amitaibenshalom/Laser-Drawing/regular_version/python/assets/homming_notification.jpg

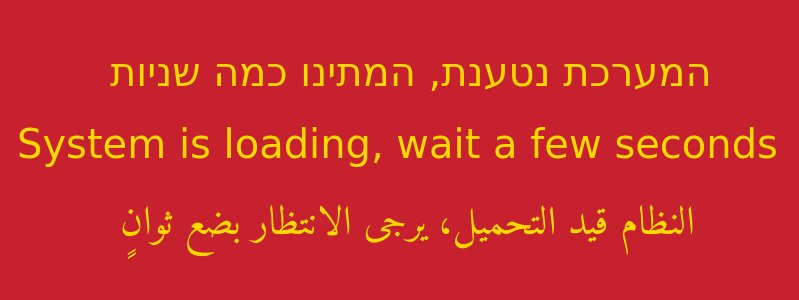
regular_version/python/assets/homming_notification.jpg
