amitaibenshalom/Laser-Drawing/שרטוטים/shield_laser.JPG

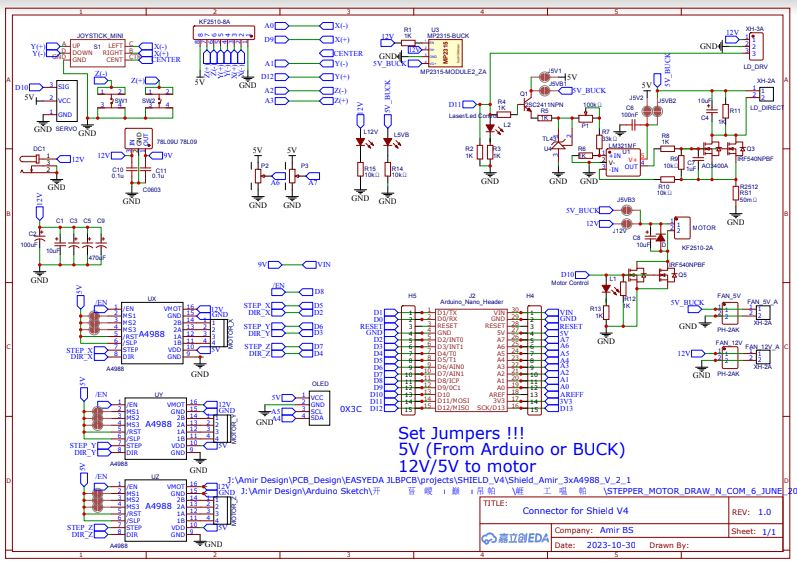
שרטוטים/shield_laser.JPG
