amitaibenshalom/Laser-Drawing/regular_version/python/assets/check.png

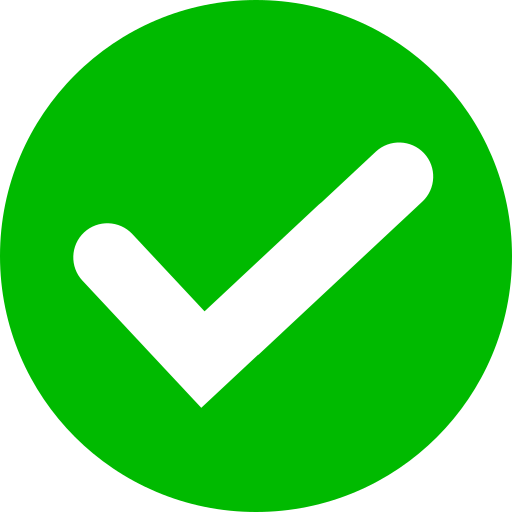
regular_version/python/assets/check.png
