amitaibenshalom/Laser-Drawing/regular_version/python/assets/circle.jpg

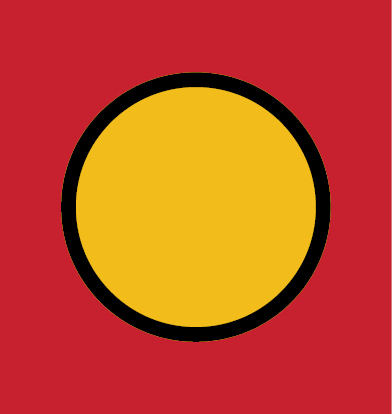
regular_version/python/assets/circle.jpg
