amitaibenshalom/Laser-Drawing/regular_version/python/assets/circlePressed.jpg

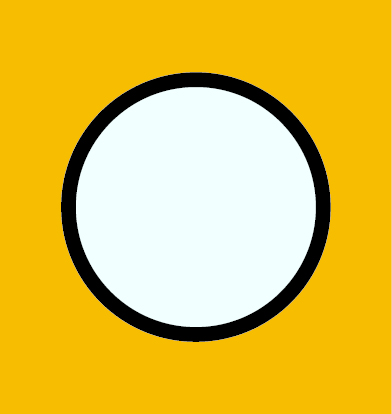
regular_version/python/assets/circlePressed.jpg
