amitaibenshalom/Laser-Drawing/regular_version/python/assets/drop.jpg

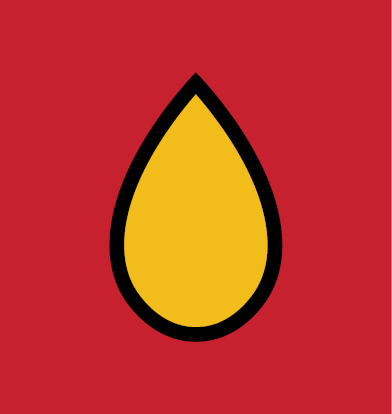
regular_version/python/assets/drop.jpg
