amitaibenshalom/Laser-Drawing/regular_version/python/assets/empty_drawing.jpg

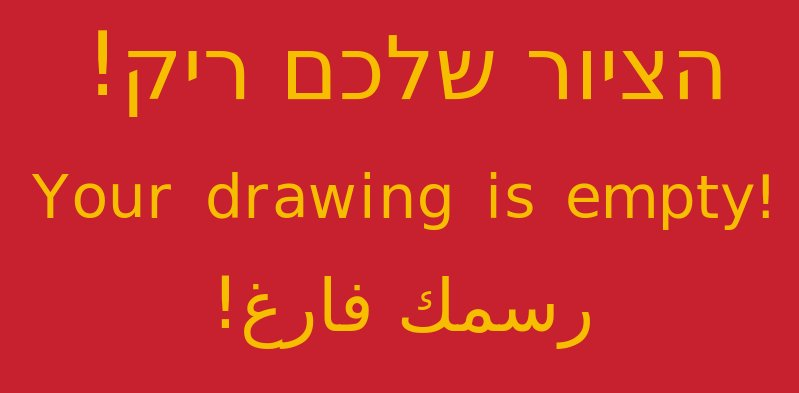
regular_version/python/assets/empty_drawing.jpg
