amitaibenshalom/Laser-Drawing/regular_version/python/assets/eraser.png

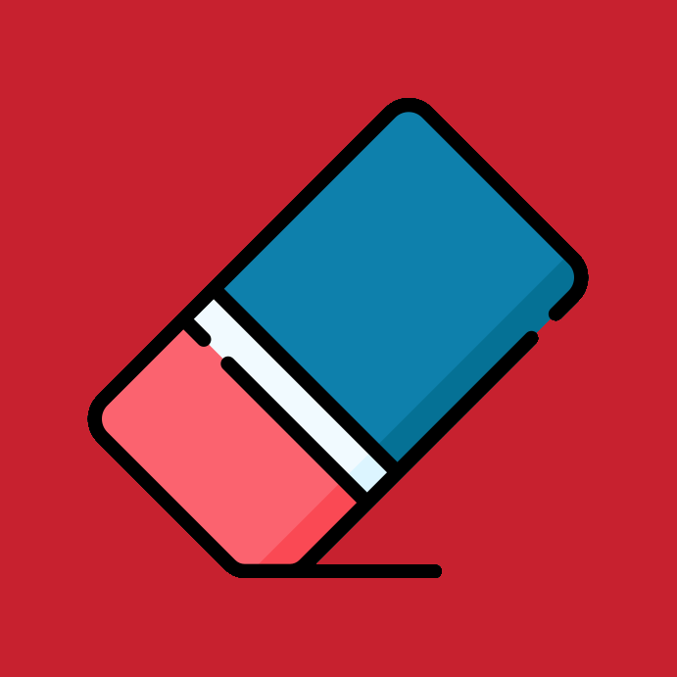
regular_version/python/assets/eraser.png
