amitaibenshalom/Laser-Drawing/regular_version/python/assets/eraserPressed.png

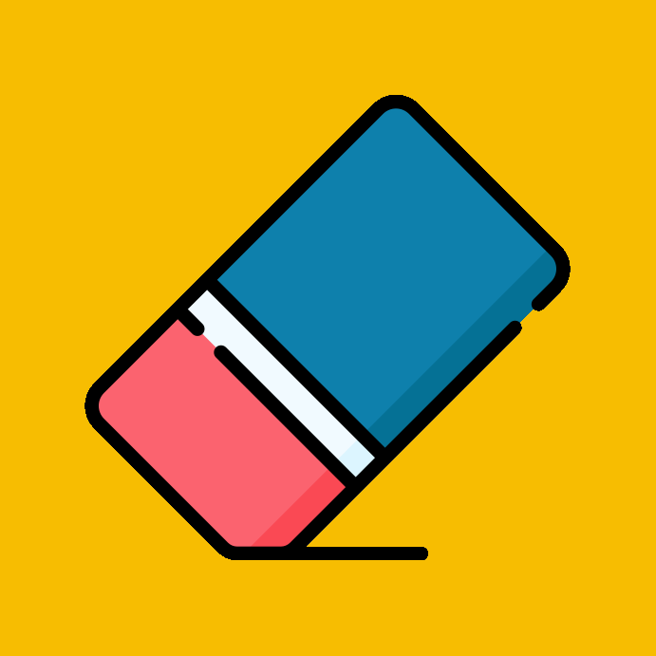
regular_version/python/assets/eraserPressed.png
