amitaibenshalom/Laser-Drawing/regular_version/python/assets/extimated_time_text.jpg

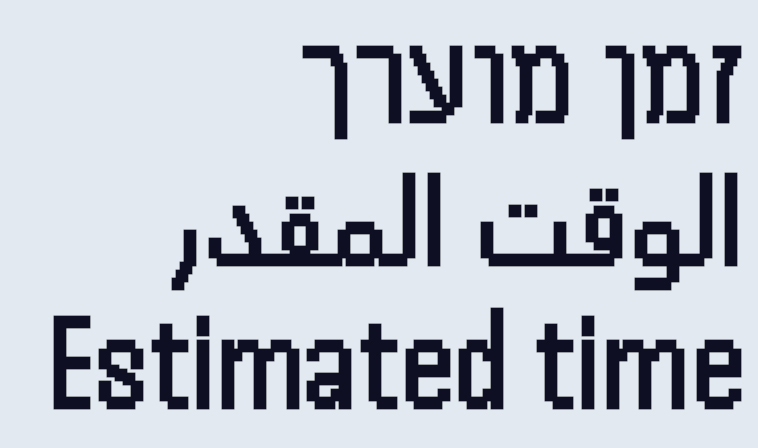
regular_version/python/assets/extimated_time_text.jpg
