amitaibenshalom/Laser-Drawing/regular_version/python/assets/frame.jpg

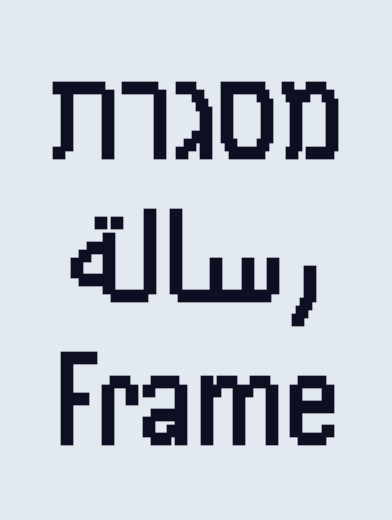
regular_version/python/assets/frame.jpg
