amitaibenshalom/Laser-Drawing/regular_version/python/assets/garbage.png

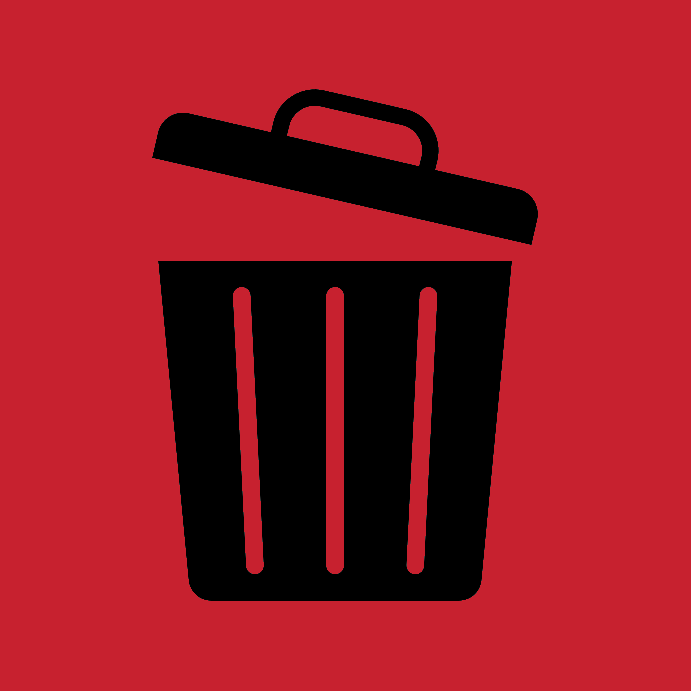
regular_version/python/assets/garbage.png
