amitaibenshalom/Laser-Drawing/regular_version/python/assets/garbagePressed.png

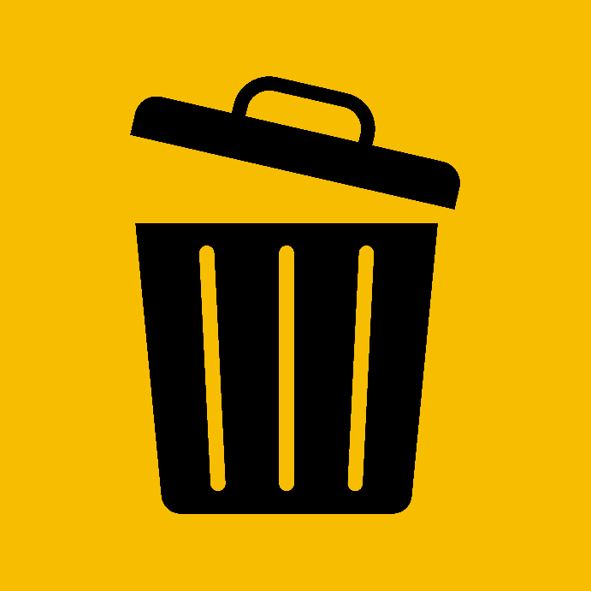
regular_version/python/assets/garbagePressed.png
