amitaibenshalom/Laser-Drawing/regular_version/python/assets/heart.jpg

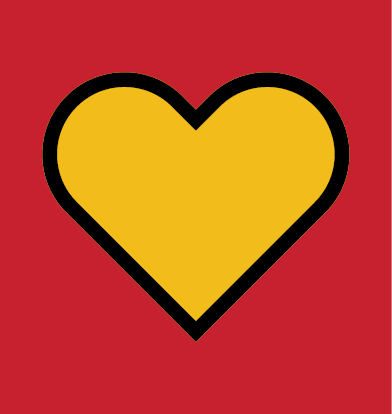
regular_version/python/assets/heart.jpg
