amitaibenshalom/Laser-Drawing/regular_version/python/assets/heartPressed.jpg

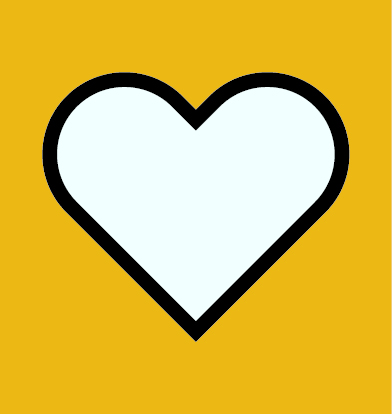
regular_version/python/assets/heartPressed.jpg
