amitaibenshalom/Laser-Drawing/regular_version/python/assets/laser_drawing_example.png

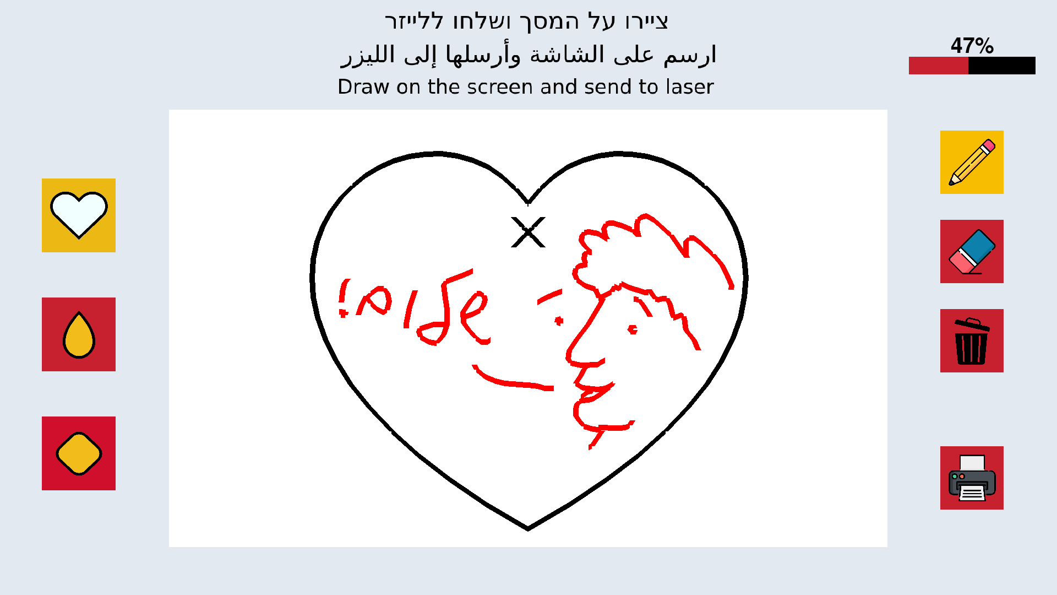
regular_version/python/assets/laser_drawing_example.png
