amitaibenshalom/Laser-Drawing/regular_version/python/assets/no.png

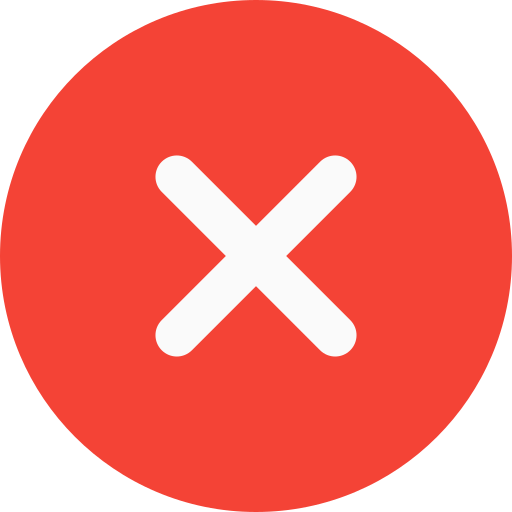
regular_version/python/assets/no.png
