amitaibenshalom/Laser-Drawing/regular_version/python/assets/pencil.png

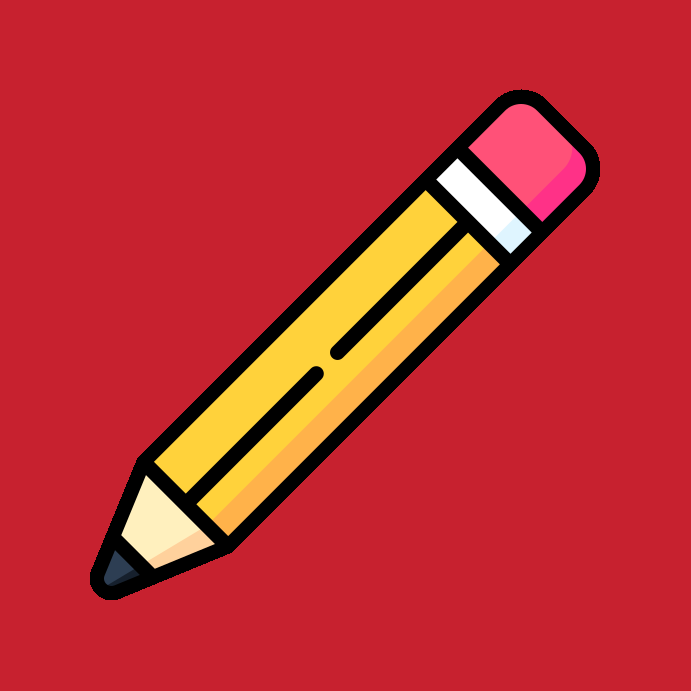
regular_version/python/assets/pencil.png
