amitaibenshalom/Laser-Drawing/regular_version/python/assets/pencilPressed.png

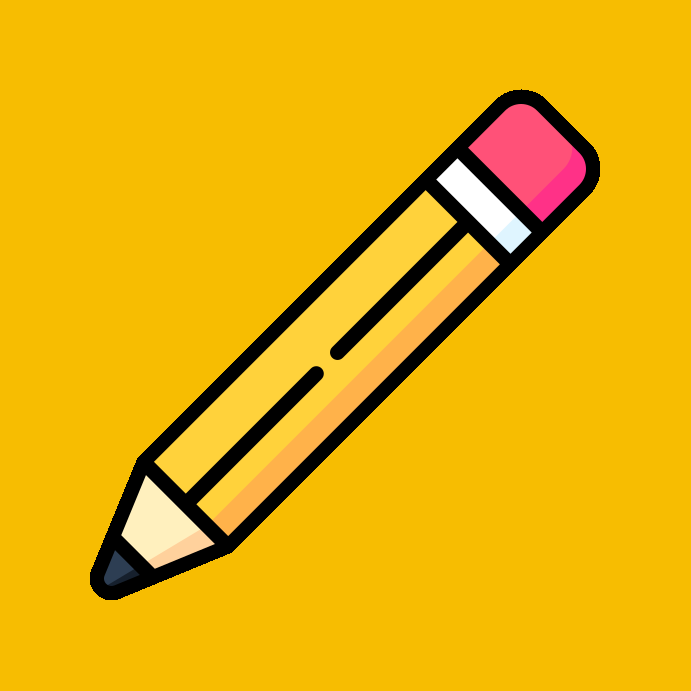
regular_version/python/assets/pencilPressed.png
