amitaibenshalom/Laser-Drawing/regular_version/python/assets/preview.jpg

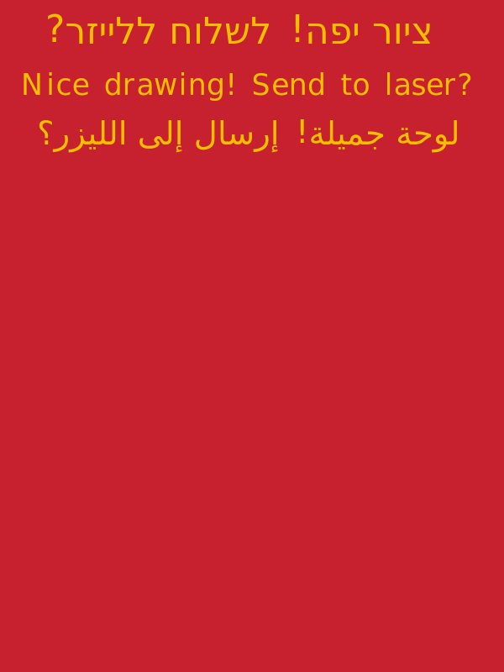
regular_version/python/assets/preview.jpg
