amitaibenshalom/Laser-Drawing/regular_version/python/assets/square.jpg

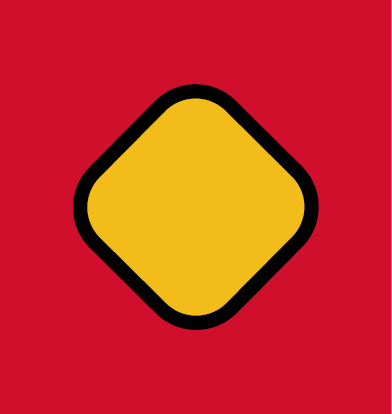
regular_version/python/assets/square.jpg
