amitaibenshalom/Laser-Drawing/regular_version/python/assets/textAbove2.jpg

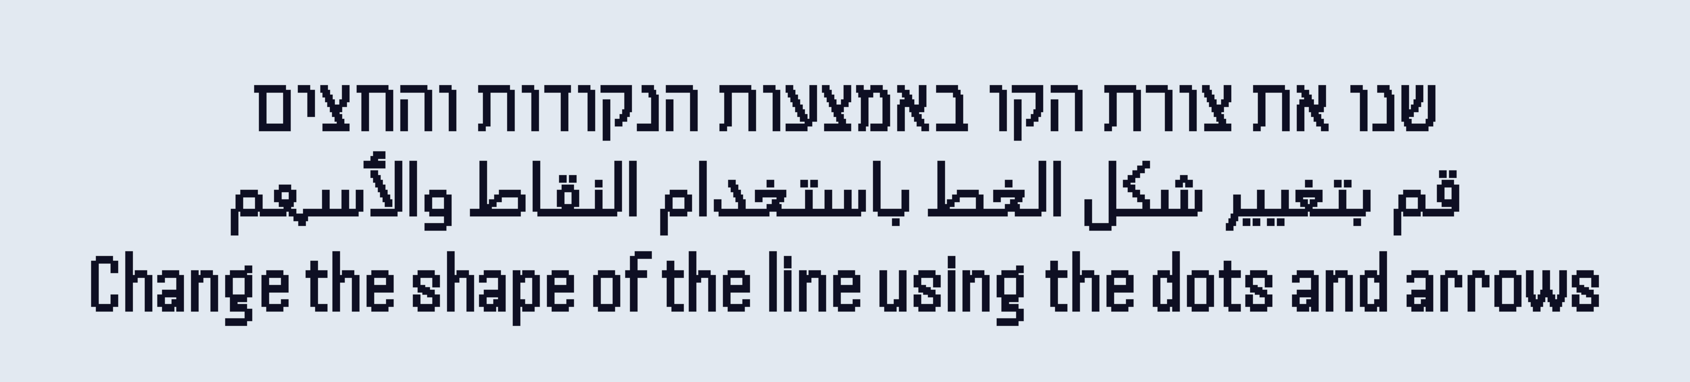
regular_version/python/assets/textAbove2.jpg
