amitaibenshalom/Laser-Drawing/regular_version/python/assets/title.png

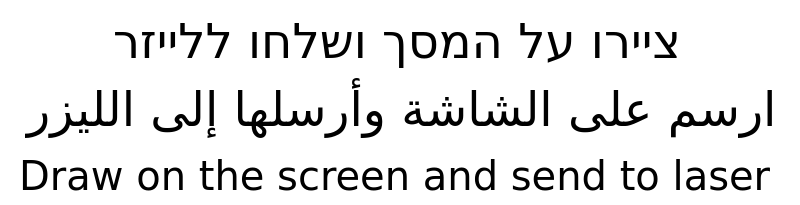
regular_version/python/assets/title.png
