amitaibenshalom/Laser-Drawing/שרטוטים/shield_laser2.JPG

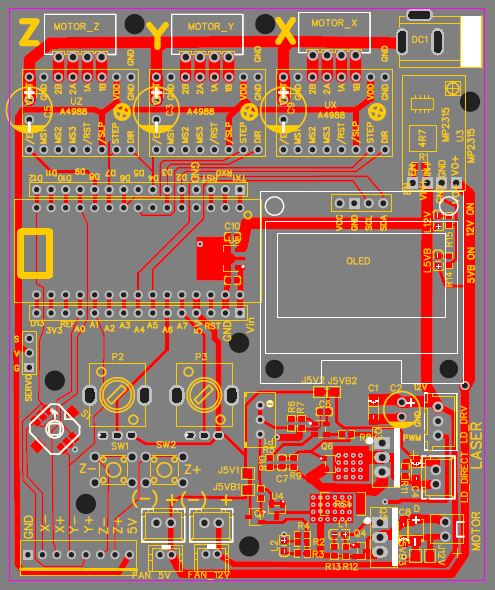
שרטוטים/shield_laser2.JPG
