amitaibenshalom/Laser-Drawing/regular_version/python/assets/printer.png

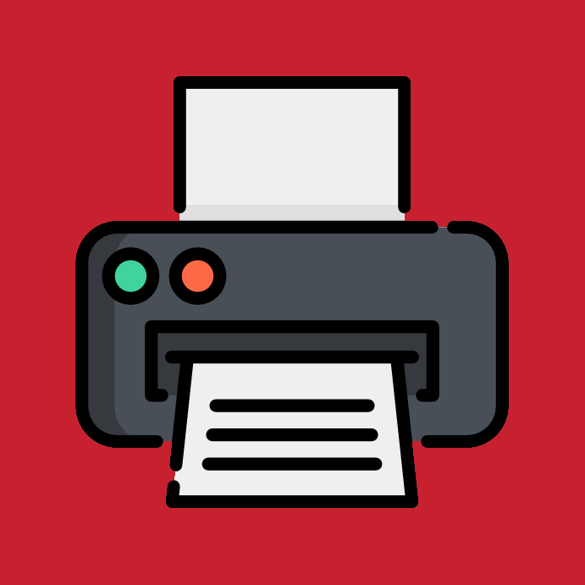
regular_version/python/assets/printer.png
