amitaibenshalom/Laser-Drawing/regular_version/python/assets/printerOff.png

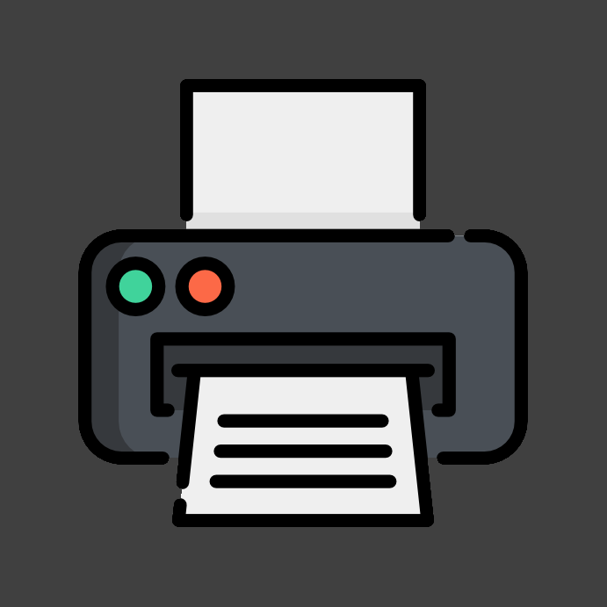
regular_version/python/assets/printerOff.png
