amitaibenshalom/Laser-Drawing/regular_version/python/assets/printerPressed.png

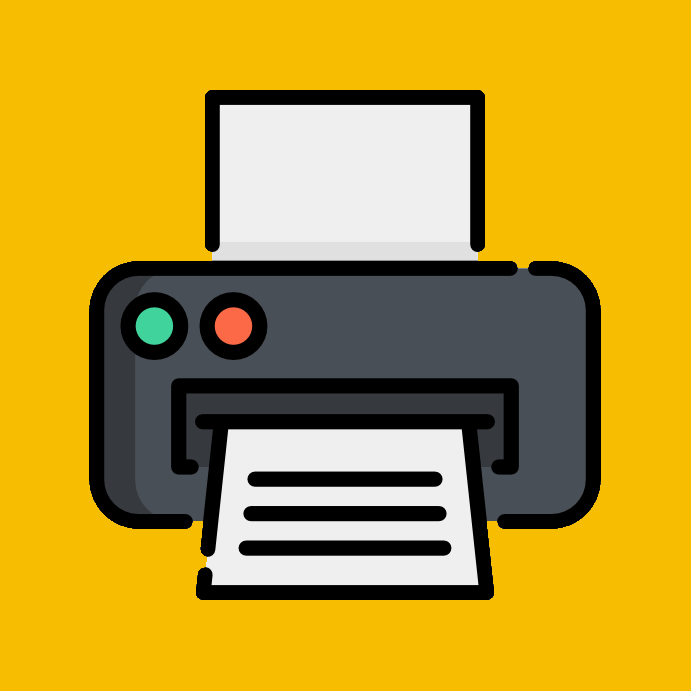
regular_version/python/assets/printerPressed.png
