amitaibenshalom/Laser-Drawing/regular_version/arduino/Laser-Drawing-Regular/consts.h

#ifndef CONSTS_H
#define CONSTS_H

#include <Arduino.h>

#define BAUDRATE (115200)

//=========motor and draw area parameters================
#define NUMBER_OF_MOTORS 2  // X, Y
#define NUMBER_OF_MOVES 4  // X+, X-, Y+, Y-
const float board_size[NUMBER_OF_MOTORS] = {83.0,83.0};  // mm

//=============start blink led parameters=================
const uint8_t START_LED_BLINK_NUMBER = 3;
const uint16_t START_LED_BLINK_ON = 100;  // ms
const uint16_t START_LED_BLINK_OFF = 200;  // ms

//==================IO pin define =======================
const byte MOVE_PIN[NUMBER_OF_MOVES] = {9, 16, 10, 15}; // push buttons to move (X+, X-, Y+, Y-)
const byte DIR_PIN[NUMBER_OF_MOTORS] = {2, 3}; // original on V4 Shield
const byte STEP_PIN[NUMBER_OF_MOTORS] = {5, 6}; // original on V4 Shield

#define IS_EN_JUMPER 17  // High is disable, low enable this is for all 3 drivers/motors
#define STEPPER_EN_PIN 8  // invert - High is disable, low enable this is for all 3 drivers/motors
#define SPEED_POT_INPUT_PIN A6  // analog read IO mark A6 on shield 
#define LED_OUT 13  // also internal led
#define LASER_OUT 11  // pwm drive for laser
#define DC_MOTOR_OUT 10  // pwm drive for dc motor

const float MIN_POSITION[NUMBER_OF_MOTORS] = {0, 0};
const float MAX_POSITION[NUMBER_OF_MOTORS] = {board_size[0], board_size[1]};

//==================timming/rate parameters ===============
const uint16_t DIRECTION_CHANGE_WAIT_TIME = 5;  // [ms] time wait/stop move between change direction
const uint16_t MIN_RATE = 6;  // ms - minimum time between steps pulses - fastest speed
const uint16_t MAX_RATE = 150;  // ms - maximum, time between steps pulses - slowest speed
const uint16_t HOMMING_RATE = MIN_RATE;
const float TOLERANCE = 0.1;  // tolerance for not move 

//----- global variables------------------

float mm_per_pulse[NUMBER_OF_MOTORS]= {0.2, 0.2};
float border[4] = {437.0, 147.0, 930.0, 620.0};  // x, y, xMax, yMax - all in pixels, this is calibrated later dynamically
float screen_scale[2] = {board_size[0] / (border[2] - border[0]), board_size[1] / (border[3] - border[1])};  // units: [mm]/[pixel]

bool is_destination_done = true;
int16_t current_steps[NUMBER_OF_MOTORS] = {0, 0};
int16_t MIN_STEPS[NUMBER_OF_MOTORS] = {0, 0};
int16_t MAX_STEPS[NUMBER_OF_MOTORS] = {3500, 3500};
int16_t HOMMING_STEPS[NUMBER_OF_MOTORS] = {board_size[0] / mm_per_pulse[0], board_size[1] / mm_per_pulse[1]};
int16_t STEPS_TO_CENTER = 270;

float current_position[NUMBER_OF_MOTORS] = {0.0, 0.0};
float destination[NUMBER_OF_MOTORS] = {0.0, 0.0};
float delta[NUMBER_OF_MOTORS] = {0.0, 0.0};  // sqrt(X^2+Y^2)
float MAX_DELTA[NUMBER_OF_MOTORS]= {TOLERANCE * abs(mm_per_pulse[0]), TOLERANCE * abs(mm_per_pulse[1])};  // max delta between current pos and destination  

byte laser_power = 255;
byte dc_motor_power = 255;
uint16_t rate = MIN_RATE; // register hold rate (read from potentiometer)

byte LASER_ON_POWER = 255;
byte FRAME_POWER = 255;
uint16_t LASER_OFF_RATE = MIN_RATE;
uint16_t LASER_ON_RATE = 80;
uint16_t FRAME_RATE = 80;
uint16_t MAX_DC_MOTOR_TIME = 1500;
const uint8_t PARAMS_NUMBER = 10;
const uint16_t TIME_DELAY_FOR_FRAME_CUTTING = 110; // delay in ms for letting the laser stay on a little longer for contour to be cut properly 
const uint32_t SERIAL_TIMEOUT_ERROR = 5000;  // if drawing from python, and waiting for data exceeded this timeout, then turn laser off

bool is_PBs_pressed = false ; // for enable/disable motors if no PB pressed
bool motor_direction[NUMBER_OF_MOTORS] = {false, false}; // initialy asume arbitary direction - false count pulses down
uint32_t last_pulse_time[NUMBER_OF_MOVES] = {0, 0, 0, 0};
uint16_t prop_rates[NUMBER_OF_MOVES] = {MIN_RATE, MIN_RATE, MIN_RATE, MIN_RATE}; // proportinal rates
uint16_t rates[NUMBER_OF_MOVES] = {MIN_RATE, MIN_RATE, MIN_RATE, MIN_RATE}; // initial value same rates
uint16_t homming_rates[NUMBER_OF_MOVES] = {HOMMING_RATE, HOMMING_RATE, HOMMING_RATE, HOMMING_RATE}; // initial value same rates

uint32_t last_time_dc_motor = 0;
uint32_t last_time_got_data = 0;

bool is_laser_on = false;
bool is_dc_motor_on = false;
bool dc_motor_stay_on = false;

//------------python related ---------------------
const float tolerance_float = 0.1;
const byte points_buffer_size = 20;  // max number of points to save at any moment

const String START_KEY = "START";
const String PARAMS_KEY = "PARAMS";
const String ACK_KEY = "OK";
const String BATCH_DONE_KEY = "B_DONE";
const String DRAWING_DONE_KEY = "D_DONE";
const String FRAME_DONE_KEY = "F_DONE";
const String RESET_KEY = "RESET";

bool processing_drawing = false;  // in the whole process of drawing (from start to finish)
bool drawing_batch = false;  // physically now drawing the batch of points
bool getting_params = false;  // if processing params
bool drawing_frame = false;  // true after switching to frame

float points[2 * points_buffer_size] = {};
byte point_index = 0;
byte param_index = 0;
byte batch_size = 0;

String input = "";
float x, y;

#endif // CONSTS_H
