amitaibenshalom/Laser-Drawing/regular_version/python/main.py

"""
Filename: main.py
Purpose: Main file for the exhibit - run me
Author: Amitai Ben Shalom
"""

import time
import pygame
from pygame.locals import *
from consts import *
from asset_loader import *
from ui import Ui
from logs import *


def main():

    logger = get_logger()
    logger.info("Starting Laser Drawing Exhibit")
    
    pygame.init()
    pygame.display.set_caption("Laser Drawing")
    clock = pygame.time.Clock()
    
    if FULLSCREEN:
        screen = pygame.display.set_mode((0, 0), pygame.FULLSCREEN)
        screen_width, screen_height = pygame.display.Info().current_w, pygame.display.Info().current_h
        view_port = (screen_width, screen_height)

    else:
        screen = pygame.display.set_mode(VIEWPORT)
        view_port = VIEWPORT
    
    ui = Ui(screen, view_port, logger)

    mouse_down = False
    running = True
    while running:
        for event in pygame.event.get():
            if event.type == QUIT or (event.type == KEYDOWN and event.key == K_ESCAPE):
                running = False

            if event.type == KEYDOWN and event.key == K_r:
                ui.repeat = [not ui.repeat[0], 0]
                ui.on_screen_message = REPEAT_MODE_ON_MESSAGE if ui.repeat[0] else None

            if event.type == KEYDOWN and event.key == K_h:
                ui.homming()

            elif event.type == pygame.MOUSEBUTTONDOWN:
                if event.button == 1:
                    mouse_down = True
                    ui.handle_point(event.pos)
                    ui.last_touch_idle = time.time()
                    ui.repeat_mode_off()  # if user touched the screen, turn off repeat mode

            elif event.type == pygame.MOUSEBUTTONUP:
                if event.button == 1:  # Left click released
                    mouse_down = False
                    ui.end_stroke()
                    ui.last_touch_idle = time.time()
    
        if mouse_down:
            mouse_pos = pygame.mouse.get_pos()
            ui.handle_point(mouse_pos)

        ui.detect_hidden_homming_combo()
        ui.check_idle()
        ui.handle_laser()
        ui.render_screen()

        pygame.display.flip()
        clock.tick(30)


if __name__ == "__main__":
    main()
