amitaibenshalom/Laser-Drawing/(commit log)

2024-06-01 basic arduino codes
2025-05-21 added frames
2025-05-21 laser wip
2025-05-23 arduino in python side
2025-05-24 WIP arduino
2025-05-26 added dc motor
2025-05-26 added laser protection
2026-03-18 restart on arduino wont fuck program
2026-03-31 added overlapping for frames and fixed repeat mode
    [main.py, ui.py]
